teamvalgrind/TeamValgrind-WRO-2025/models /Sistema de Transmisión Motriz Trasero/README.md

Imagen de WhatsApp 2025-06-13 a las 22 14 21_c5e34e08

En nuestro sistema dedicado de transmisión trasera tenemos palieres y ejes de transmisión totalmente impresos en 3D los cuales dividimos en 5 partes

Inicialmente contamos con La copa del Diferencial; Gracias a este acople nos permite variar el grosor de los palieres y distancia entre la rueda y la transmisión,  asimismo más versatilidad en el rango de movimiento dado por el palier, robusta para una resistencia mecánica excepcional

Imagen de WhatsApp 2025-06-13 a las 22 23 46_622ee615

Seguido de La copa de diferencial está El Palier de transmisión trasera;
Este permite la potencia rotacional del diferencial directamente hacía las ruedas, lo cual permite un movimiento fluido y limpio de las mismas, reforzado para soportar la potencia rotacional y los movimientos de dirección y suspensión

Imagen de WhatsApp 2025-06-13 a las 22 29 32_efa944a1

Para transmitir el movimiento directamente a la rueda tenemos La Junta trasera, la cual esta conectada mecánicamente directamente a la rueda y a los Palieres de transmisión; Reposa sobre 2 cojinetes a medida (12x8x3.5) los cuales permiten transmitir la fuerza rotacional de manera eficiente y estable a las ruedas, con un diseño con un tornillo M2 interno para aportarle rigidez y estabilidad estructural

Imagen de WhatsApp 2025-06-13 a las 22 35 18_7b2dfa9f

Acoplado directamente a la Junta Trasera, nos encontramos con el Ring de encaje hexagonal, el cual es el encargado de transformala potencia rotacional de los diferenciales, Palieres y Juntas en movimiento físico del robot de manera eficiente y fluida

Imagen de WhatsApp 2025-06-13 a las 22 38 02_b38a46af

Por último nos encontramos con el Pivote trasero,en el cual reposa todo el sistema de cojinetes los cuales le dan libertad de movimiento a las Ruedas, Palieres y Juntas, este esta fijo atornillado al Chasis para proporcionarle estabilidad total al sistema

Imagen de WhatsApp 2025-06-13 a las 22 40 45_d5034267

Como diseño Extra quisimos agregar un Alineador de transmisión trasera, fijo al chasis, este nos da un rango de alineación de las ruedas traseras para poder aportar una transmisión estable y precisa

Imagen de WhatsApp 2025-06-13 a las 22 43 35_d7d401e9

Imagen de WhatsApp 2025-06-13 a las 22 44 36_969d7c80
