teamvalgrind/TeamValgrind-WRO-2025/models /Heimdall-Final-Version/README.md

Dentro de este directorio está la versión 
.step definitiva de nuestro robot, junto con algunas fotos ilustrativas:

(https://postimg.cc/3yS3LLyw)

(https://postimg.cc/VdWQG7pc)

(https://postimg.cc/xJMFk8SS)

(https://postimg.cc/3yS3LLyw)
