teamvalgrind/TeamValgrind-WRO-2025/models / README.md

# Modelos del Robot – Carpeta `models`

¡Bienvenido a la carpeta de modelos!
Aquí encontrarás todos los archivos y documentación relacionados con los componentes físicos y mecánicos del robot, especialmente aquellos diseñados y listos para impresión 3D.

---

## Estructura de Carpetas y Descripción

A continuación se detallan las subcarpetas principales que conforman este directorio, junto a una breve descripción de su propósito:

---

### 1. **Bases y Acoples de Sensores y Cámara**
- **Descripción:**  
  Aquí se encuentran los modelos 3D de las bases y acoples para la fijación de sensores y la cámara del robot. 

### 2. **Cajas de Diferencial y Chasis Principal**
- **Descripción:**  
  Contiene los archivos de diseño para la estructura principal del robot, incluyendo el chasis central y las cajas del diferencial. Estos modelos brindan el soporte estructural necesario y alojan los mecanismos internos de transmisión y control.

---

### 3. **Impresión y Diseño 3D**
- **Descripción:**  
  Reúne los archivos fuente (STL, STEP, etc.) y documentación relacionada con el proceso de diseño e impresión 3D. Aquí se incluyen guías para la fabricación, recomendaciones de materiales, y configuraciones de impresión.

---

### 4. **Sistema de Movimiento Libre y Dirección Delantera**
- **Descripción:**  
  Incluye los modelos para los sistemas delanteros de dirección y movimiento libre. Aquí se encuentran los componentes que permiten al robot girar y maniobrar con precisión.
---

### 5. **Sistema de Transmisión Motriz Trasero**
- **Descripción:**  
  Contiene los diseños de la transmisión motriz trasera, tales como soportes de motores, engranajes, ejes y acoples. Estos elementos son fundamentales para el desplazamiento eficiente y la entrega de potencia a las ruedas traseras del robot.

---

> [!NOTE]
>  ¿Cómo usar estos modelos?
> 1. **Revisa el README específico de cada subcarpeta** para detalles técnicos y notas de montaje.
> 2. **Descarga los archivos de la pieza que necesites** y prepáralos según las recomendaciones de impresión.
> 3. **Consulta las guías y diagramas** para el ensamblaje correcto y evitar errores durante el armado del robot.

---
