teamvalgrind/TeamValgrind-WRO-2025/models /Bases y Acoples de Sensores y Cámara/bracket de servo.stl

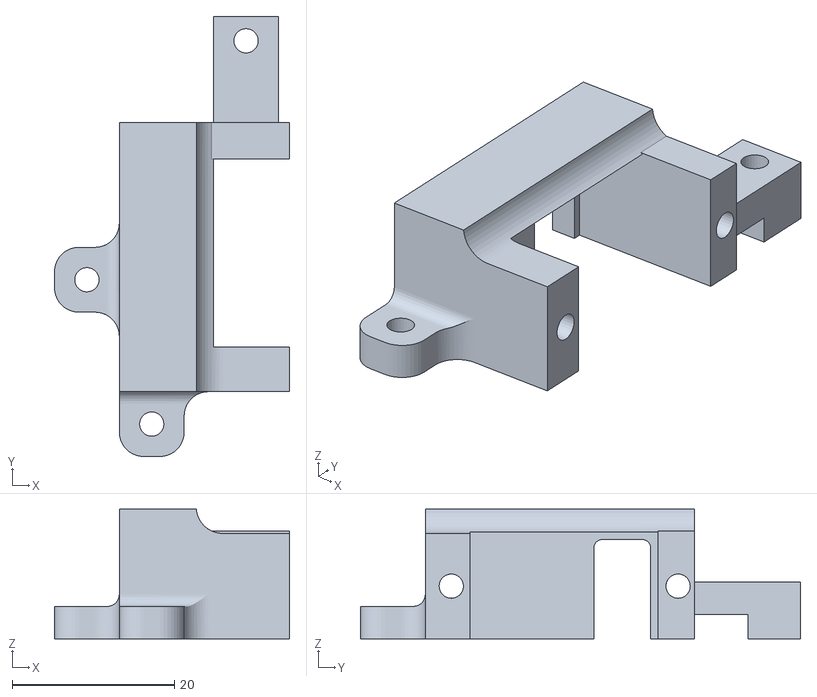
[picture p1: CAD file, 2025-09-26]
models /Bases y Acoples de Sensores y Cámara/bracket de servo.stl
29.0 x 54.3 x 16.0
