teamvalgrind/TeamValgrind-WRO-2025/models /Cajas de Diferencial y Chasis Principal/prisionero de rolinera de transmisión del motor al eje.stl

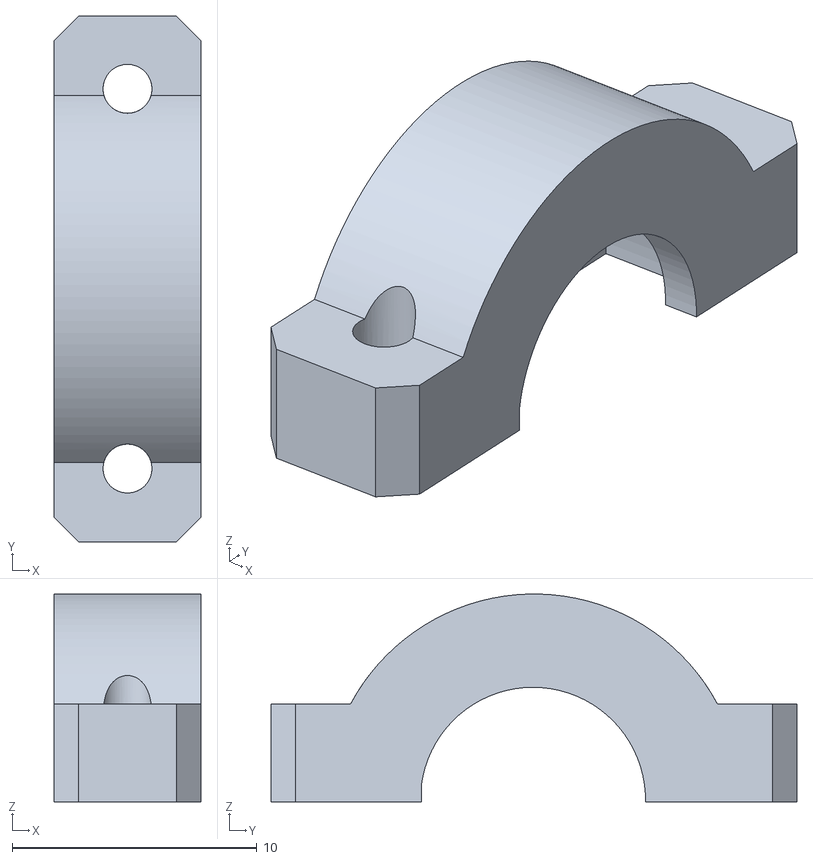
[picture p2: CAD file, 2025-09-26]
models /Cajas de Diferencial y Chasis Principal/prisionero de rolinera de transmisión del motor al eje.stl
6.00 x 21.5 x 8.50
