teamvalgrind/TeamValgrind-WRO-2025/models /Sistema de Movimiento Libre y Tracción Delantera/Junta delantera.stl

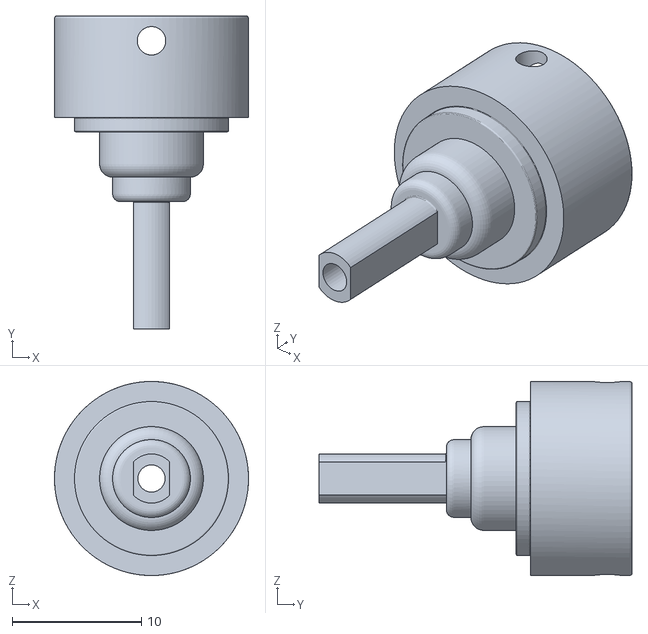
[picture p3: CAD file, 2025-09-26]
models /Sistema de Movimiento Libre y Tracción Delantera/Junta delantera.stl
15.0 x 24.2 x 15.0
