teamvalgrind/TeamValgrind-WRO-2025/models /Sistema de Transmisión Motriz Trasero/Alineador de transmisión trasera.stl

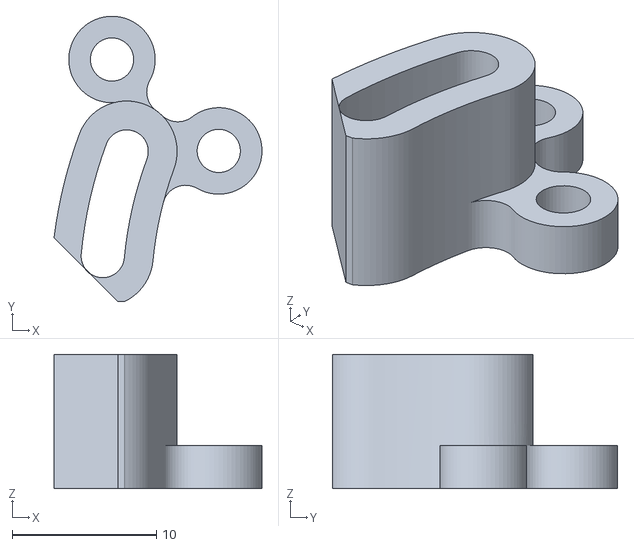
[picture p4: CAD file, 2025-09-26]
models /Sistema de Transmisión Motriz Trasero/Alineador de transmisión trasera.stl
14.4 x 19.8 x 9.31
