teamvalgrind/TeamValgrind-WRO-2025/models /Bases y Acoples de Sensores y Cámara/base de pixy.stl

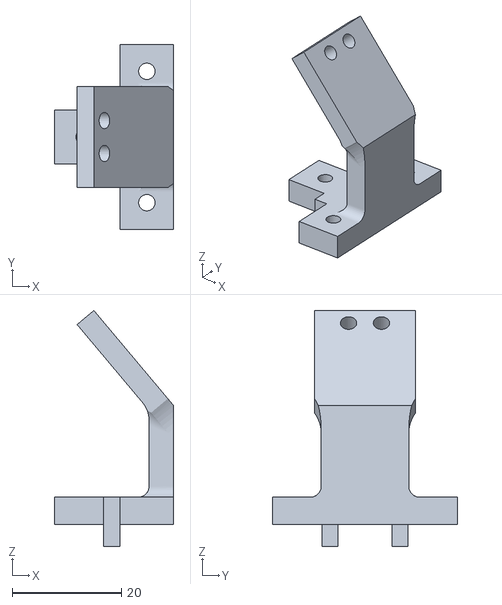
[picture p5: CAD file, 2025-09-26]
models /Bases y Acoples de Sensores y Cámara/base de pixy.stl
21.8 x 33.8 x 43.1
