teamvalgrind/TeamValgrind-WRO-2025/models /Sistema de Movimiento Libre y Tracción Delantera/Pivote frontal.stl

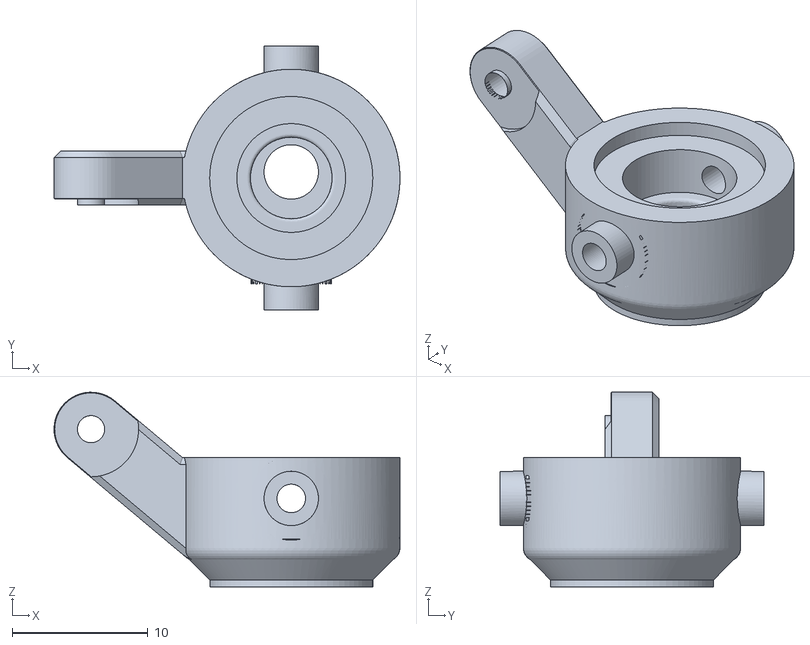
[picture p6: CAD file, 2025-09-26]
models /Sistema de Movimiento Libre y Tracción Delantera/Pivote frontal.stl
25.5 x 19.4 x 14.3
