teamvalgrind/TeamValgrind-WRO-2025/models /Sistema de Transmisión Motriz Trasero/Junta trasera.stl

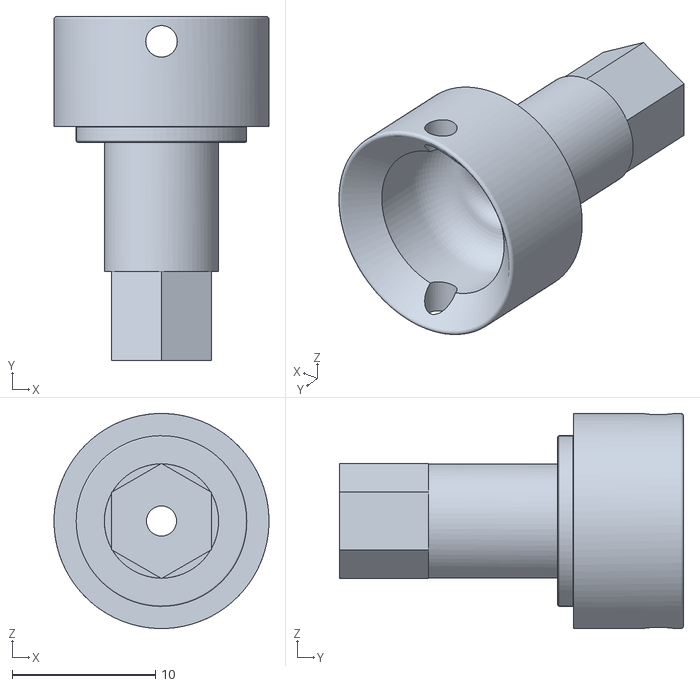
[picture p7: CAD file, 2025-09-26]
models /Sistema de Transmisión Motriz Trasero/Junta trasera.stl
15.0 x 24.0 x 15.0
