teamvalgrind/TeamValgrind-WRO-2025/models /Bases y Acoples de Sensores y Cámara/base de acople de ultrasonicos .stl

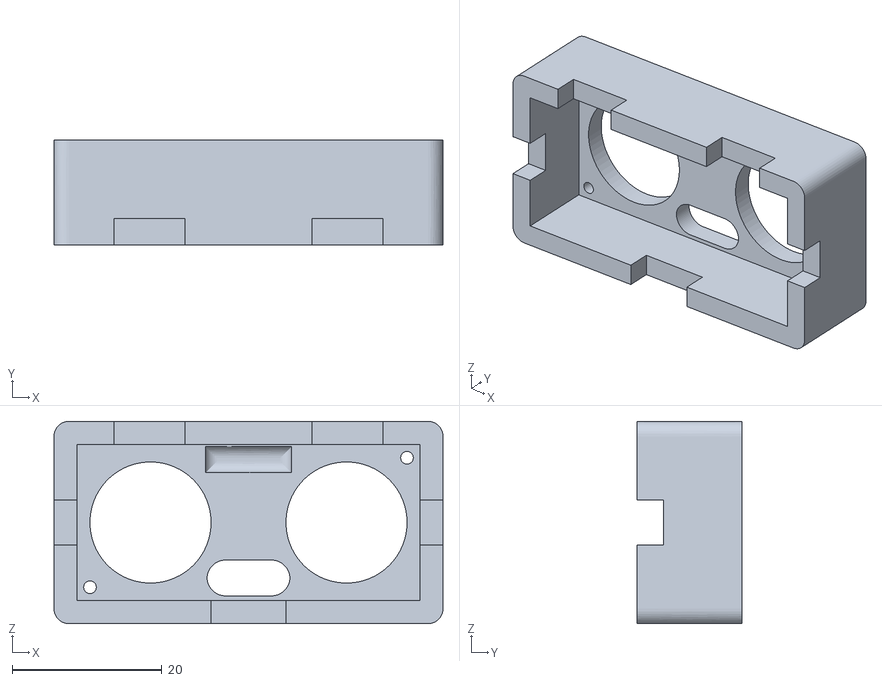
[picture p8: CAD file, 2025-09-26]
models /Bases y Acoples de Sensores y Cámara/base de acople de ultrasonicos .stl
52.0 x 14.0 x 27.1
