teamvalgrind/TeamValgrind-WRO-2025/models /Sistema de Movimiento Libre y Tracción Delantera/rueda de encaje ovalado semirecto.stl

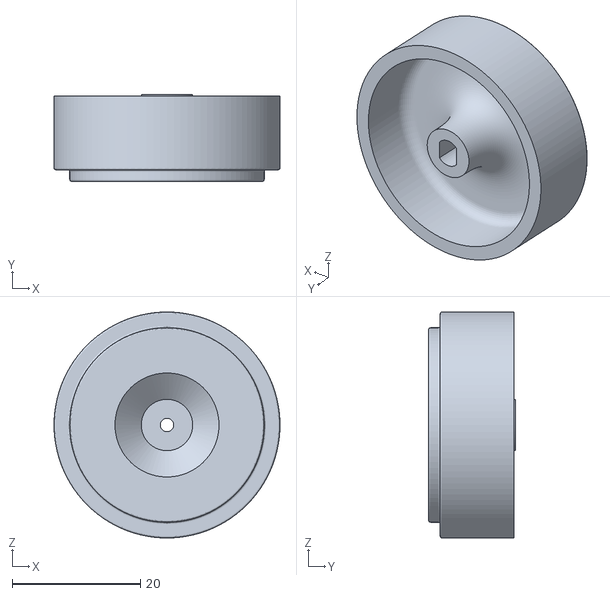
[picture p9: CAD file, 2025-09-26]
models /Sistema de Movimiento Libre y Tracción Delantera/rueda de encaje ovalado semirecto.stl
35.2 x 13.5 x 35.2
