teamvalgrind/TeamValgrind-WRO-2025/models /Sistema de Transmisión Motriz Trasero/Palier de transmisión trasera (1).stl

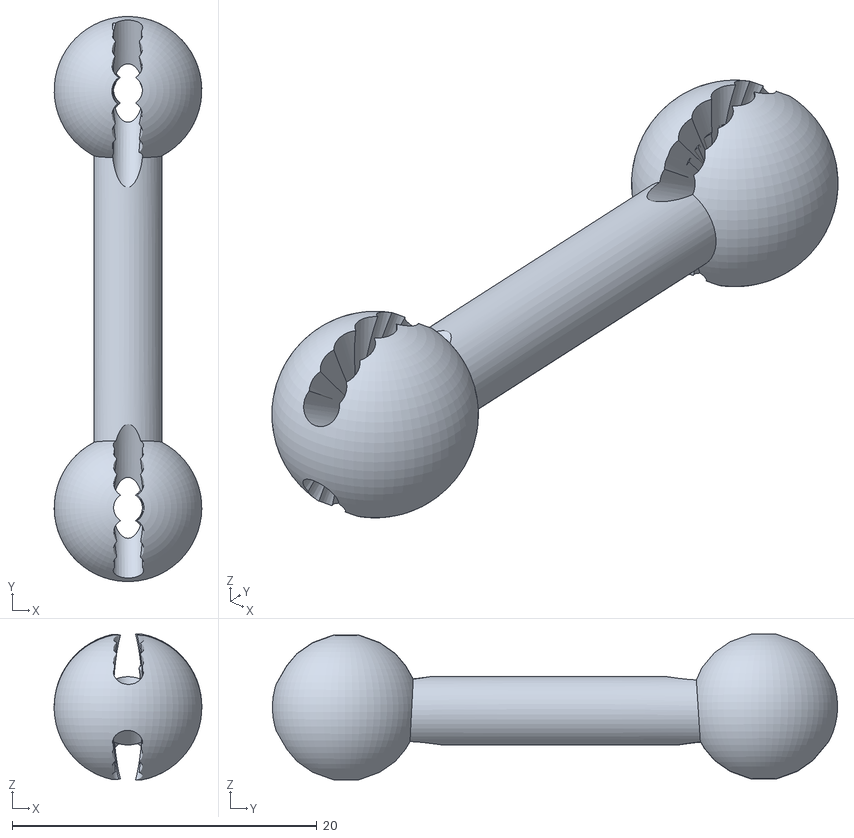
[picture p10: CAD file, 2025-09-26]
models /Sistema de Transmisión Motriz Trasero/Palier de transmisión trasera (1).stl
9.69 x 37.1 x 9.57
