teamvalgrind/TeamValgrind-WRO-2025/models /Bases y Acoples de Sensores y Cámara/base de ultrasonicos y pixy principal.stl

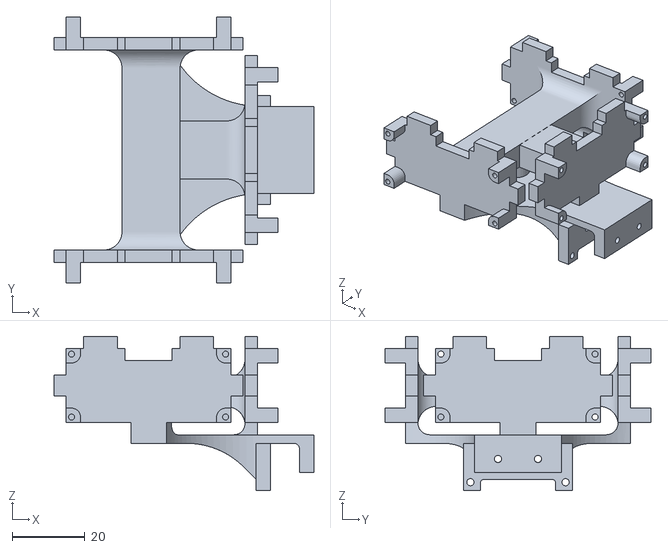
[picture p11: CAD file, 2025-09-26]
models /Bases y Acoples de Sensores y Cámara/base de ultrasonicos y pixy principal.stl
71.5 x 73.2 x 42.4
