teamvalgrind/TeamValgrind-WRO-2025/models /Sistema de Movimiento Libre y Tracción Delantera/palier de dirección derecho.stl

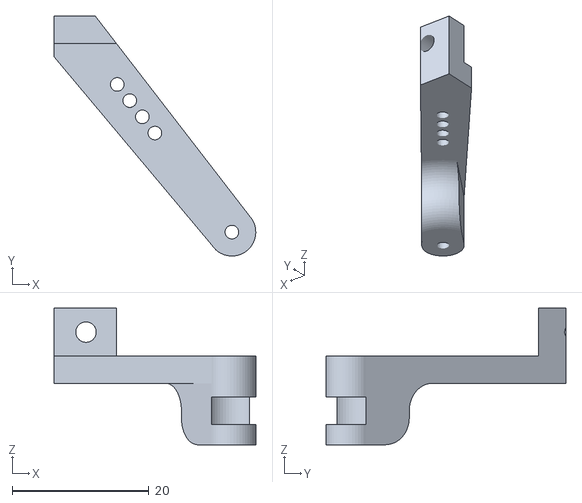
[picture p12: CAD file, 2025-09-26]
models /Sistema de Movimiento Libre y Tracción Delantera/palier de dirección derecho.stl
29.5 x 35.1 x 20.0
