teamvalgrind/TeamValgrind-WRO-2025/models /Sistema de Transmisión Motriz Trasero/ring de encaje hexagonal adaptado.stl

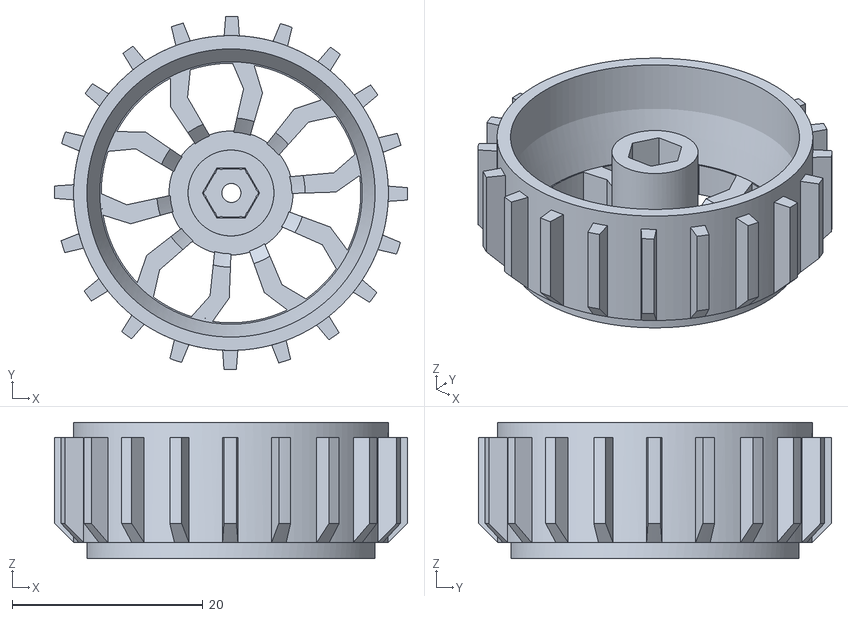
[picture p13: CAD file, 2025-09-26]
models /Sistema de Transmisión Motriz Trasero/ring de encaje hexagonal adaptado.stl
37.0 x 37.0 x 14.3
