teamvalgrind/TeamValgrind-WRO-2025/models /Bases y Acoples de Sensores y Cámara/base de motor.stl

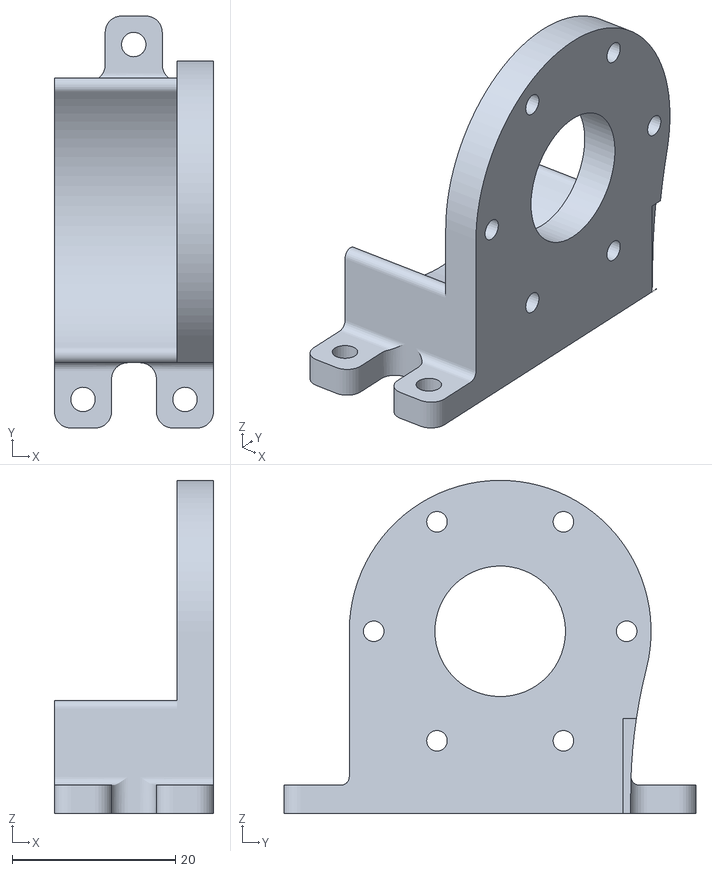
[picture p14: CAD file, 2025-09-26]
models /Bases y Acoples de Sensores y Cámara/base de motor.stl
19.5 x 50.5 x 40.8
