teamvalgrind/TeamValgrind-WRO-2025/models /Sistema de Transmisión Motriz Trasero/copa de diferencial.stl

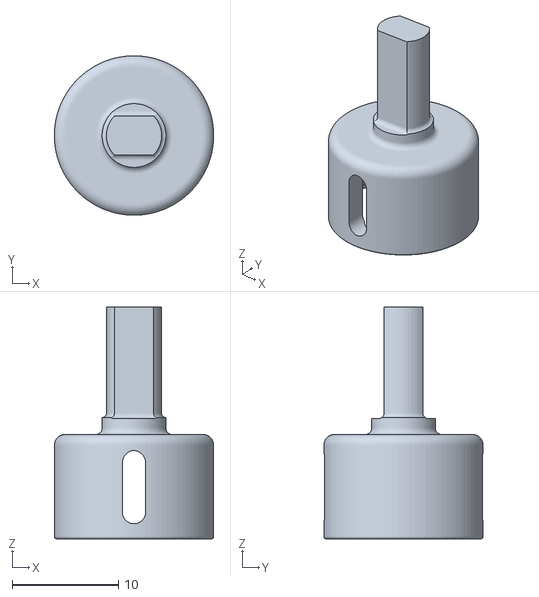
[picture p15: CAD file, 2025-09-26]
models /Sistema de Transmisión Motriz Trasero/copa de diferencial.stl
15.0 x 15.0 x 21.8
