teamvalgrind/TeamValgrind-WRO-2025/models /Sistema de Movimiento Libre y Tracción Delantera/Varilla de refuerzo de tren delantero.stl

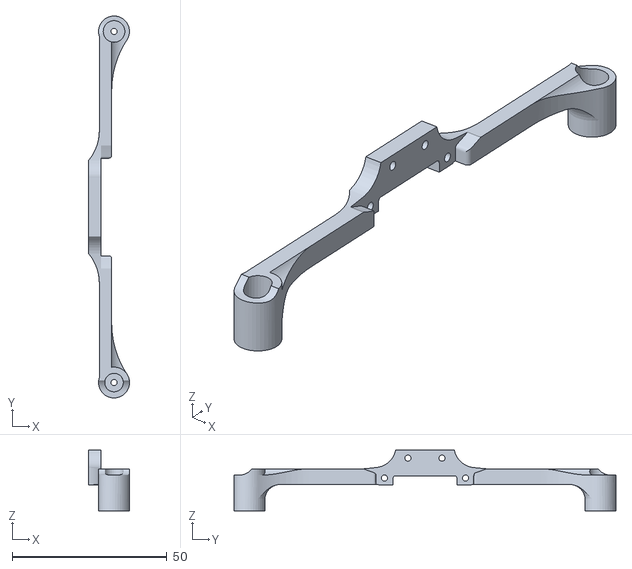
[picture p16: CAD file, 2025-09-26]
models /Sistema de Movimiento Libre y Tracción Delantera/Varilla de refuerzo de tren delantero.stl
13.3 x 123.4 x 19.6
