teamvalgrind/TeamValgrind-WRO-2025/models /Sistema de Transmisión Motriz Trasero/Pivote trasero.stl

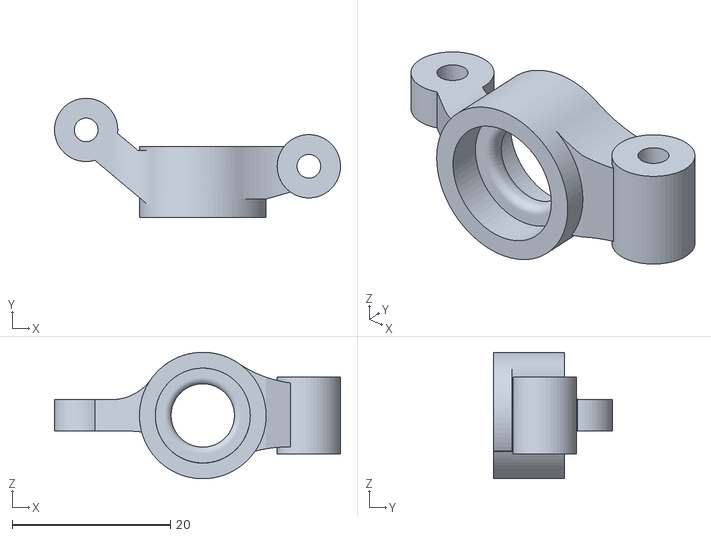
[picture p17: CAD file, 2025-09-26]
models /Sistema de Transmisión Motriz Trasero/Pivote trasero.stl
36.1 x 15.1 x 16.0
