teamvalgrind/TeamValgrind-WRO-2025/models /Sistema de Movimiento Libre y Tracción Delantera/chasis principal.stl

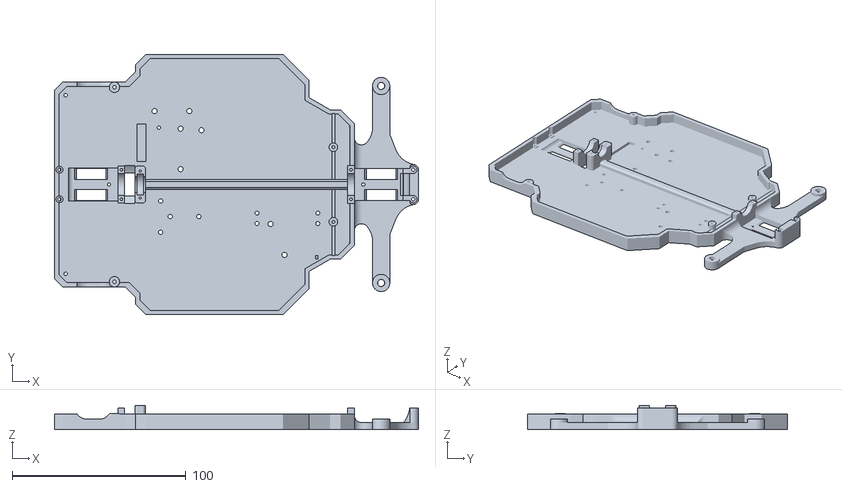
[picture p18: CAD file, 2025-09-26]
models /Sistema de Movimiento Libre y Tracción Delantera/chasis principal.stl
209.6 x 150.0 x 14.0
