teamvalgrind/TeamValgrind-WRO-2025/models /Sistema de Movimiento Libre y Tracción Delantera/caja de diferencial inferior .stl

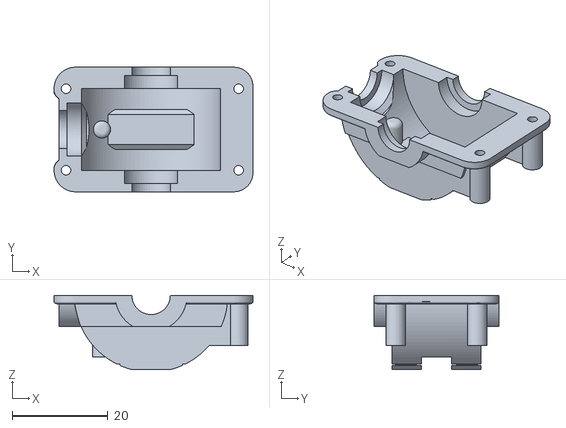
[picture p19: CAD file, 2025-09-26]
models /Sistema de Movimiento Libre y Tracción Delantera/caja de diferencial inferior .stl
41.5 x 26.0 x 15.5
