teamvalgrind/TeamValgrind-WRO-2025/models /Sistema de Movimiento Libre y Tracción Delantera/caja de diferencial superior.stl

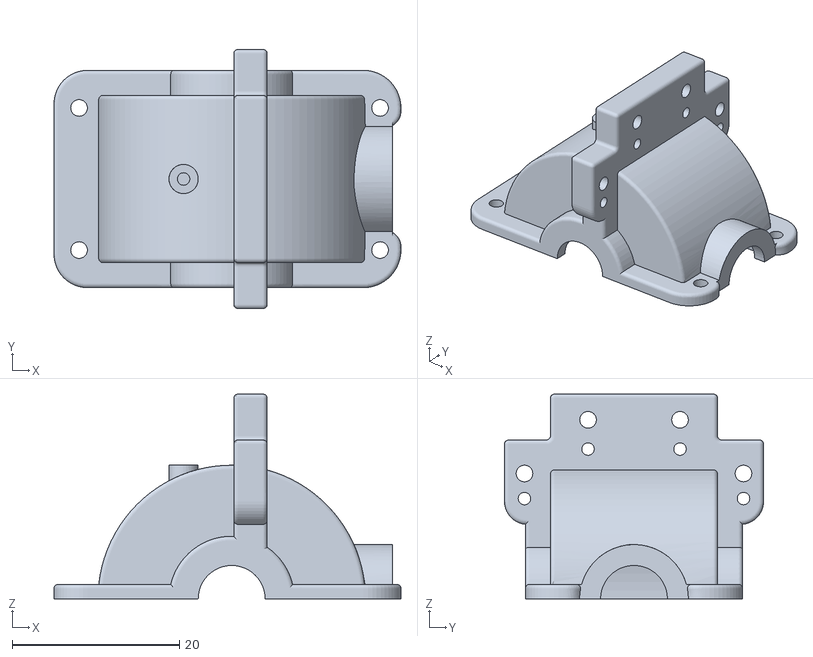
[picture p20: CAD file, 2025-09-26]
models /Sistema de Movimiento Libre y Tracción Delantera/caja de diferencial superior.stl
41.5 x 31.0 x 24.5
