teamvalgrind/TeamValgrind-WRO-2025/(list of files, cad)

Other CAD files:
models /Sistema de Movimiento Libre y Tracción Delantera/palier de dirección izquierdo.stl
