teamvalgrind/TeamValgrind-WRO-2025/(commit log)

2025-09-23 Crear Bases y Acoples de Sensores y Cámara/README.md
2025-09-23 Crear Cajas de Diferencial y Chasis Principal/README.md
2025-09-23 Crear Sistema de Movimiento Libre y Tracción Delantera/README.md
2025-09-23 Crear Sistema de Transmisión Motriz Trasero/README.md
2025-09-23 Crear pinouts-ESP32.md
2025-09-24 Crear fuerza-mecánica-flowchart.md
2025-09-25 Crear Flowchart-Abierta.md
2025-09-25 Actualizar fuerza-mecánica-flowchart.md
2025-09-25 Crear Flowchart-Cerrada.md
2025-09-25 Crear diagrama-de-conexiones.md
